fab4U/PixBlock/ReadMe.md

# PixBlock

Modular bi-color LED dot-matrix display

For a detailed description of the project see

/documentation/pixblock_english.pdf

## Installation

Download as ZIP file and install in the Arduino-IDE as a library.

## Examples

See folder "examples" for some example application code.
