fab4U/PixBlock/documentation/PixBlock RevD Assembly.pdf

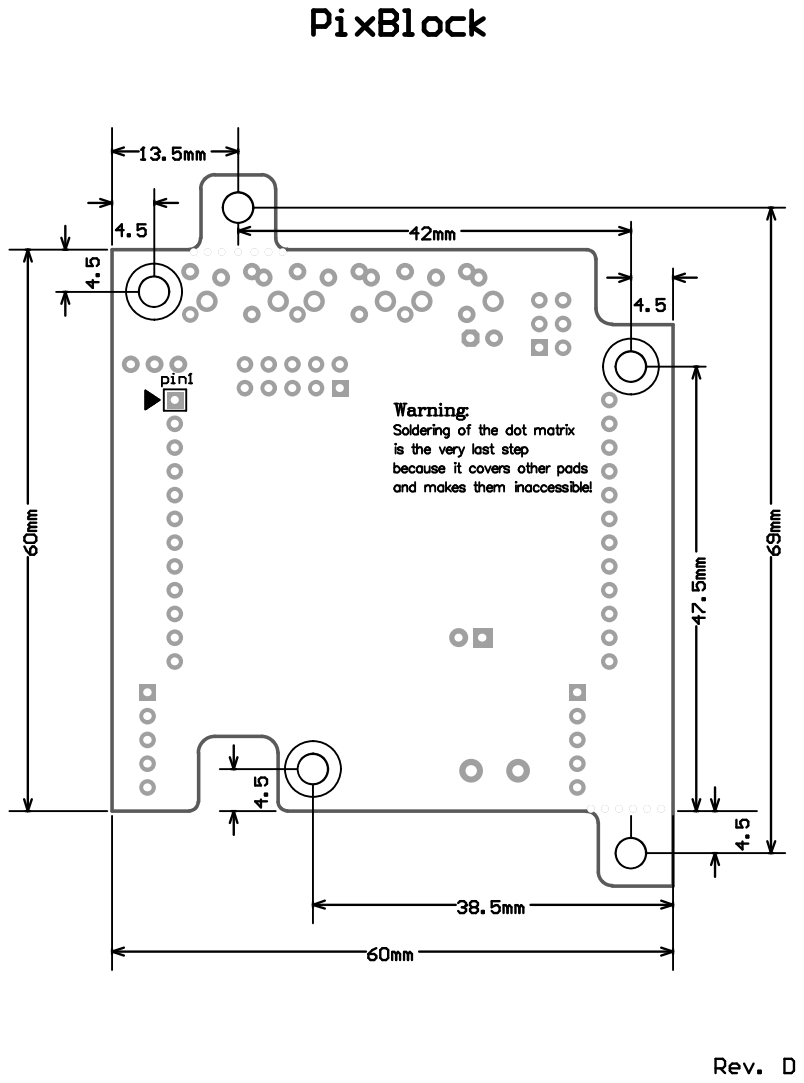
[picture p37: page 1]

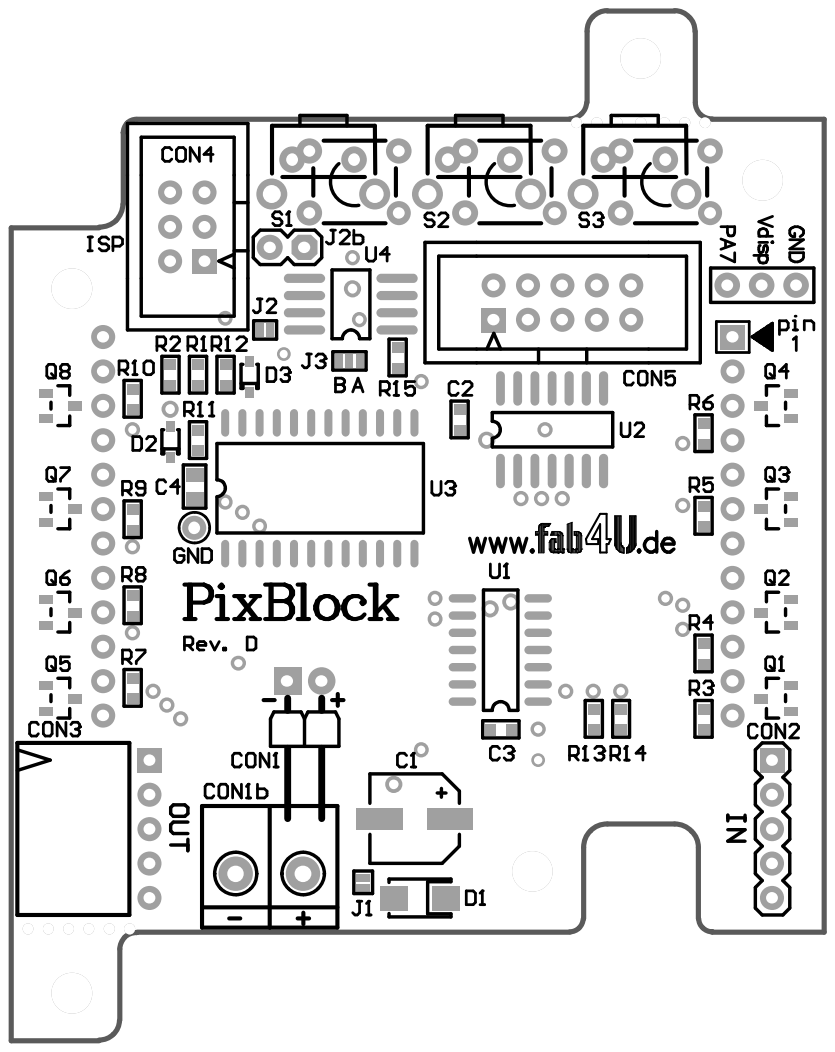
[picture p38: page 2]
