fab4U/PixBlock/documentation/PixBlock RevD Schematic.pdf

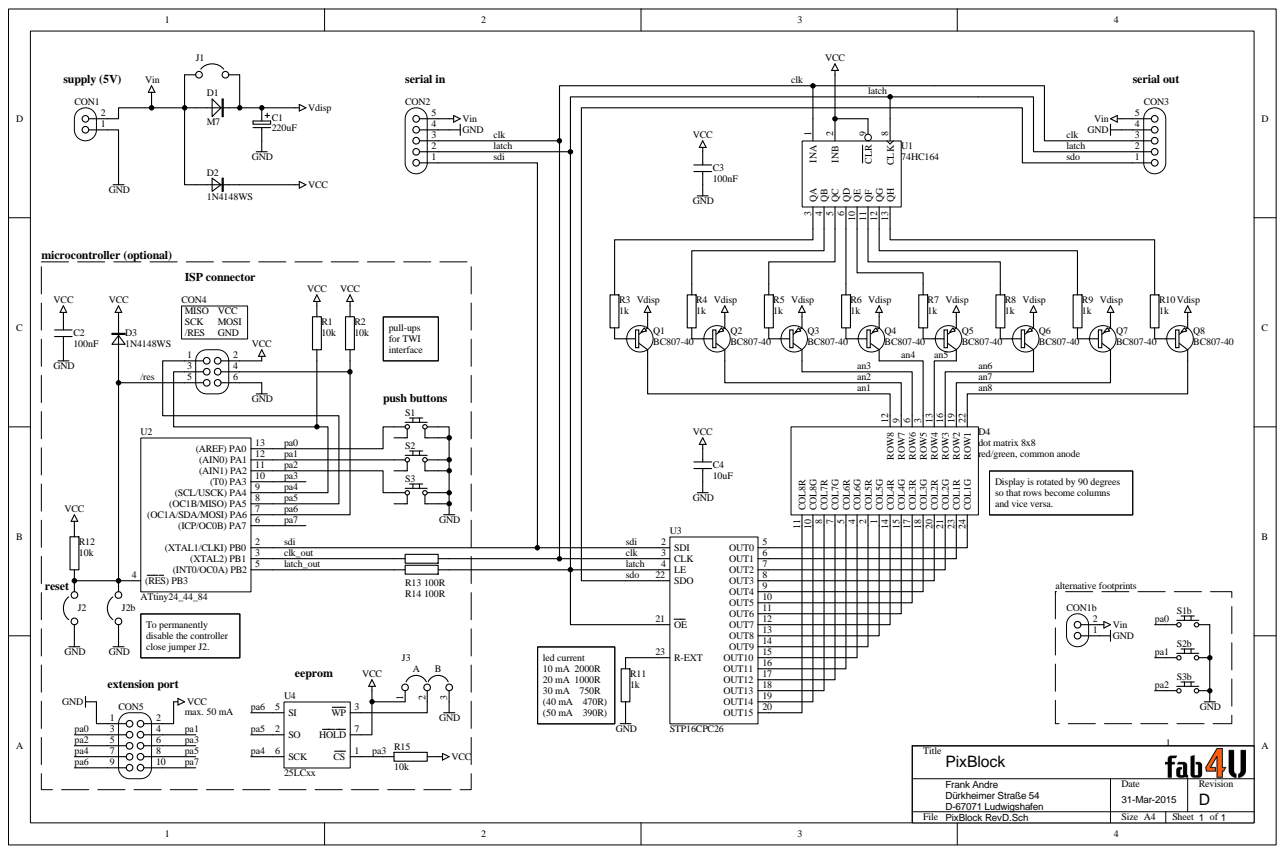
[picture p39: page 1]

Display is rotated by 90 degrees
so that rows become columns
and vice versa.
