fab4U/PixBlock/(notices)

Notices in the files:
examples/PixBlock_Simple_Demo/PixBlock_Simple_Demo.ino:
Copyright 2015: Frank Andre
License: see "license.md"
